benja1-eng/ECE455-Brainstim3/README.txt

This repository is for BrainStim group 3 "Brain Bros". The files are organized into PCB, Testing, Schematics, LTSpice, and Code.
