benja1-eng/ECE455-Brainstim3/SP26_brainstim3_final_poster_Jack_Mertes.tiff

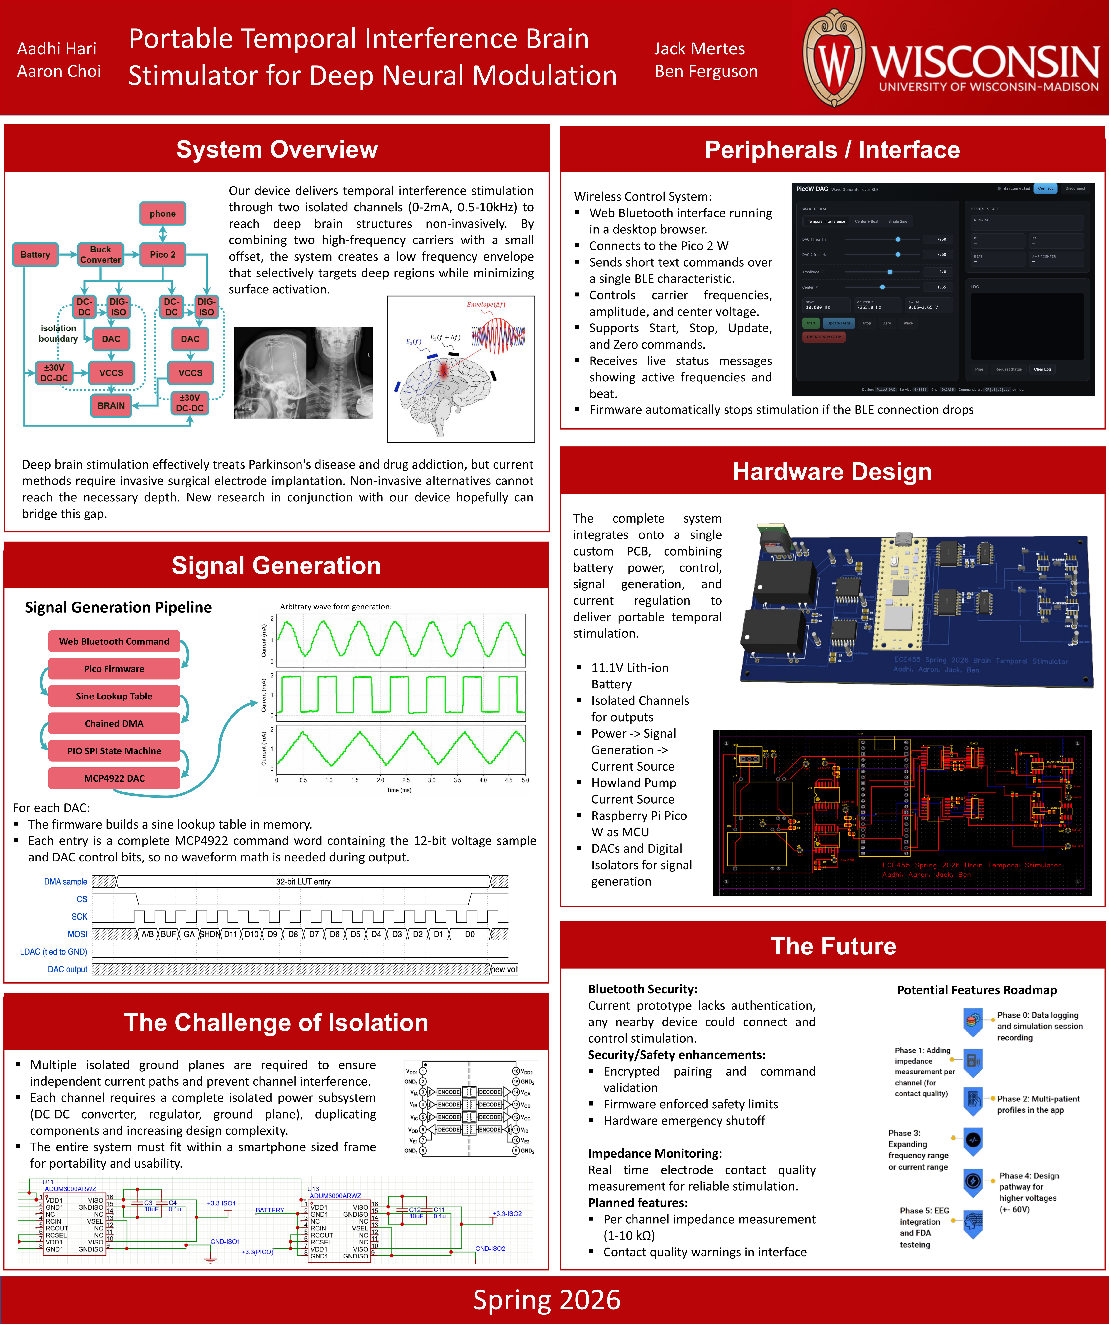
SP26_brainstim3_final_poster_Jack_Mertes.tiff
