benja1-eng/ECE455-Brainstim3/SP26_brainstim3_BOM_BenFerguson.xlsx

 | Current Source
Column 5 | Part | Description | Total Cost | Quantity
 | OPA445 | Operational Amplifier | 55.16 | 4
 | 100K Resistor | 1% Resistor | 0.80 | 8
 | 1.2K Resistor | 1% Sense Resistor | 0.20 | 2
 | Signal Generation
Column 5 | Part | Description | Total Cost | Quantity
 | Raspberry Pi Pico W | Microcontroller | 7.00 | 1
 | ADUM1401 | Digital Isolator | 14.06 | 2
 | MCP4922-E/SL | DAC | 6.94 | 2
 | 100nF Capacitor | 100nF Capacitor | 1.62 | 6
 | Power
Column 5 | Part | Description | Total Cost | Quantity
 | OKI-78SR-3.3 | Buck Converter 12V to 3.3V | 5.66 | 1
 | ADUM6000ARWZ | 3.3v DC to DC converter | 19.2 | 2
 | RW2-1215D | ±15V DC to DC | 35.18 | 2
 | 18650 Lith-Ion 3.7V | Battery | 21.99 | 3
 | Battery Holder Case | Battery Holder | 1.69 | 1
 | 0.1uF Capacitor | 0.1uF Capacitor | 0.81 | 3
 | 10uF Capacitor | 10uF Capactiro | 0.3 | 3
 | Total
Section | Part | Description | Total Cost | Quantity
Power | OKI-78SR-3.3 | Buck Converter 12V to 3.3V | 5.66 | 1
Power | ADUM6000ARWZ | 3.3v DC to DC converter | 19.2 | 2
Power | RW2-1215D | ±15V DC to DC | 35.18 | 2
Power | 18650 Lith-Ion 3.7V | Battery | 21.99 | 1
Power | Battery Holder | Battery Holder | 1.69 | 1
Power | 0.1uF Capacitor | 0.1uF Capacitor | 0.81 | 3
Power/Signal Generation | 10uF Capacitor | 10uF Capactiro | 0.3 | 3
Signal Generation | Raspberry Pi Pico W | Microcontroller | 7.00 | 1
Signal Generation | ADUM1401 | Digital Isolator | 14.06 | 2
Signal Generation | MCP4922-E/SL | DAC | 6.94 | 2
Current Source | 100nF Capacitor | 100nF Capacitor | 1.62 | 6
Current Source | OPA445 | Operational Amplifier | 55.16 | 4
Current Source | 100K Resistor | 1% Resistor | 0.80 | 8
Current Source | 1.2K Resistor | 1% Sense Resistor | 0.20 | 2
 | Total |  | 170.61
