benja1-eng/ECE455-Brainstim3/CAD/SP26_brainstim3_box_cad_Jack_Mertes.stl

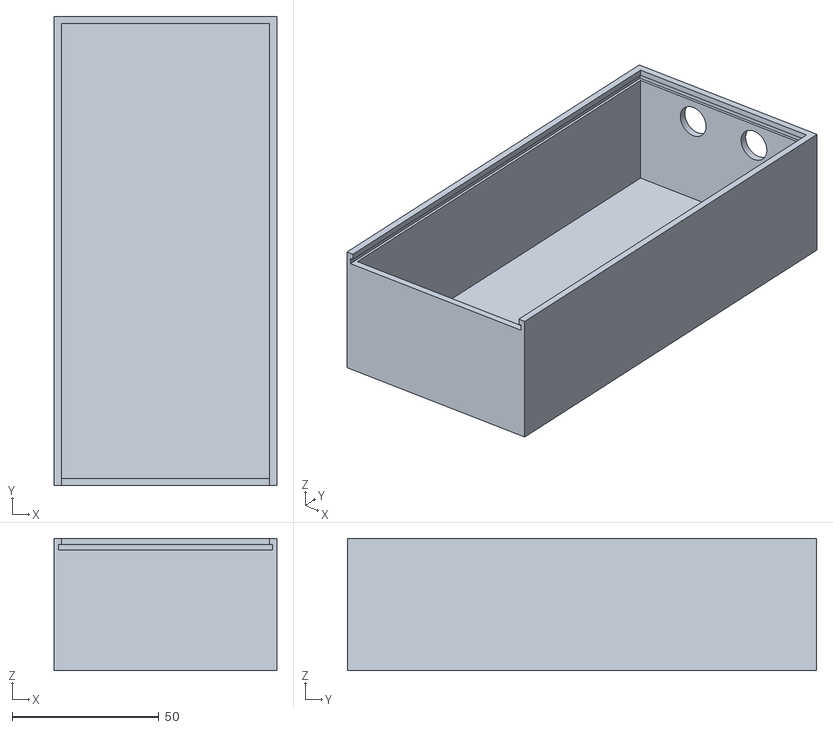
[picture p2: CAD file, 2026-05-05]
CAD/SP26_brainstim3_box_cad_Jack_Mertes.stl
76.0 x 160.0 x 45.0
