benja1-eng/ECE455-Brainstim3/CAD/SP26_brainstim3_lid_cad_Jack_Mertes.stl

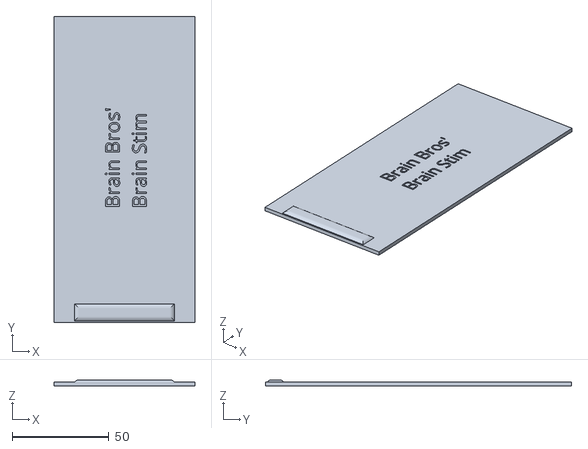
[picture p3: CAD file, 2026-05-05]
CAD/SP26_brainstim3_lid_cad_Jack_Mertes.stl
73.0 x 158.5 x 3.20
