benja1-eng/ECE455-Brainstim3/LTSPICE-Testing/SP26_brainstim3_VoltageControlledCurrentSource_BenFerguson/SP26_brainstim3_improvedHowlandPump_BenFerguson.asc

R1: res; 100K
R2: res; 100k
R3: res; 100k
R4: res; 100k
R5: res; 1200
Rload: res; {load}
U1: opamp2; OPA445
U2: opamp2; OPA445
V1: voltage; SINE(0 1.20 10000)
V2: voltage; 30
V3: voltage; -30
Named nets: 0, +30, -30
.lib OPA445.lib
.tran 0 3ms 0 1u
.step param load list 10k 15k 20k
