benja1-eng/ECE455-Brainstim3/(list of files, drawings)

Other design files:
Schematics/SP26_brainstim3_VCCS Schematic(easyEDA STD)_BenFerguson.json
Schematics/SP26_brainstim3_wholeCircuitSchematic(easyEDAPRO)_BenFerguson.epro
