benja1-eng/ECE455-Brainstim3/SP26_brainstim3_PowerPrototypeverification_AadhiHari.pdf

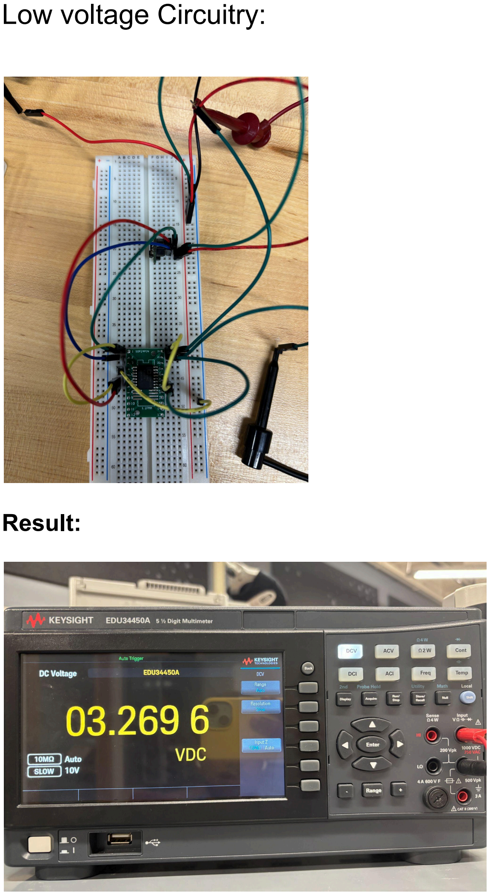
[picture p4: page 1]

Low voltage Circuitry:

Result:

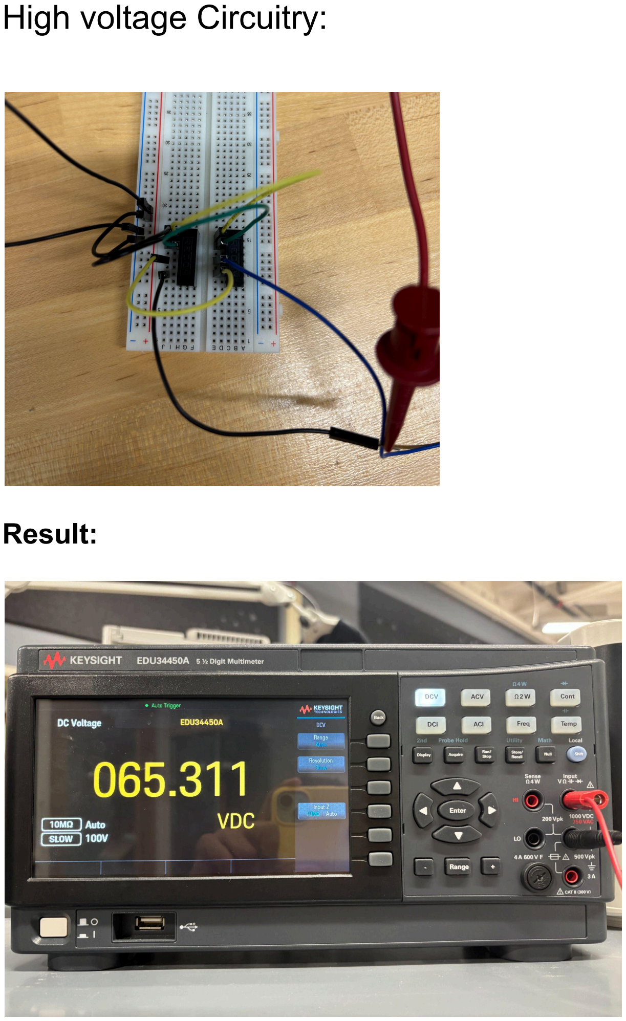
[picture p5: page 2]

High voltage Circuitry:

Result:
