benja1-eng/ECE455-Brainstim3/SP26_brainstim3_VCCS Prototype verification_BenFerguson.pdf

Vin = 0.2V AC peak to peak
Frequency (HZ) | Current (mA)
1000 | 1.95
5000 | 1.95
10000 | 1.95
Table 1. Frequency vs Current with 10k load
Load | Current
9973 | 1.95 mA
15146 | 1.91 mA
21894 | 1.87 mA
Table 2. Load vs Current with 1KHz Vin
Shape | Current mA
Sin | 1.95
Square | 1.95
Triangle | 1.95

Table 3. Input shape vs Current with 1KHZ and 10K Load

Conclusions
Max Current Draw Across all tests: 0.009 AMPS (9mA)
Current source is accurate across tests, stays consistent between load, frequency, and shape. Small deviations are due to unideal parts with normal tolerances.
