benja1-eng/ECE455-Brainstim3/(commit log)

2026-05-05 Mertes files added
    [SP26_brainstim3_box_cad_Jack_Mertes.stl, SP26_brainstim3_lid_cad_Jack_Mertes.stl]
2026-05-06 cad folder
    [SP26_brainstim3_box_cad_Jack_Mertes.stl, SP26_brainstim3_lid_cad_Jack_Mertes.stl]
